zoeyfyi/SmartHomeAdapters/robot/README.md

# Smart Home Adapters - Robot

## Setup 

1. Copy wifi.h into the esp8266 directory `cp wifi.h esp8266/`
2. Enter your SSID and password into wifi.h

## Compile & Run

Use the Arduino IDE
