zoeyfyi/SmartHomeAdapters/reports/technical-report/images/NodeMCU.png

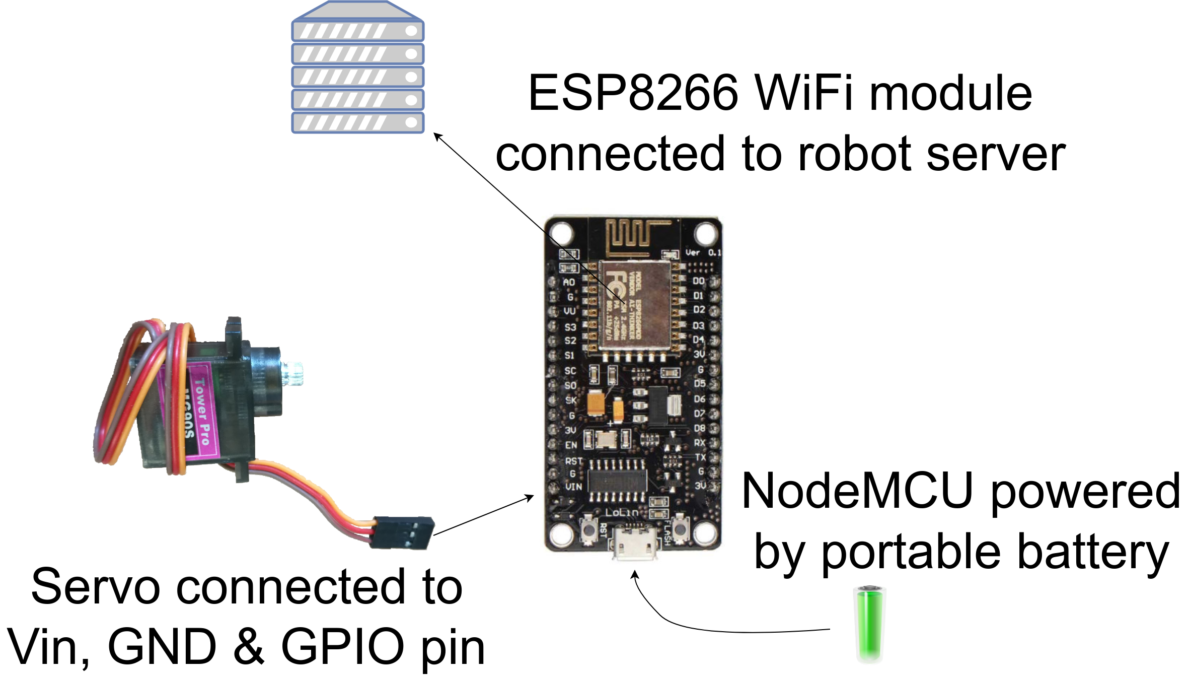
reports/technical-report/images/NodeMCU.png
