zoeyfyi/SmartHomeAdapters/robot/uno-r3/uno-r3.ino

#include <Servo.h>

#define SERVO_PIN 9

Servo servo;

// the setup function runs once when you press reset or power the board
void setup() {
  // begin serial communications
  Serial.begin(9600);
  delay(10);
  
  // initialize digital pin LED_BUILTIN as an output.
  pinMode(LED_BUILTIN, OUTPUT);
  digitalWrite(LED_BUILTIN, LOW);

  // initialize servo
  servo.attach(SERVO_PIN);
}

// the loop function runs over and over again forever
void loop() {
  if(Serial.available() > 0){
      String command = Serial.readString();
      command.trim();

      Serial.print("Received command: ");
      Serial.print(command);
      Serial.println();

      // process LED commands
      if (command.startsWith("led")) {
        if(command == "led on") {
            Serial.println("Turning LED on");
            digitalWrite(LED_BUILTIN, HIGH);
        } else if (command == "led off") {
            Serial.println("Turning LED off");
            digitalWrite(LED_BUILTIN, LOW);
        }
      }

      if (command.startsWith("servo")) {
        // convert characters after "servo " to int
        int angle = command.substring(6).toInt();

        Serial.print("Setting servo to ");
        Serial.print(angle);
        Serial.println(" degrees");

        servo.write(angle);
      }
  }
}
