zoeyfyi/SmartHomeAdapters/(commit log)

2019-01-24 feat: added valid email check and user feedback
    Added checking if the given email matches the
    regex for valid email addresses in AuthenticationActivity
    and RegisterUserActivity.
    Made strings such as button text and input hints
    more intuitive and pleasant as discussed in pull request #31.
    fix: minor typos in the activities.
2019-01-25 docs(project plan): insert gantt chart
2019-01-25 fix(robot): LED not working
    [esp8266.ino]
2019-01-26 feat(robot server): send led on/off message with http request
    /led/on turns the led on
    /led/off turns the led off
2019-01-26 feat(robot): turn led on/off when message is received
2019-01-26 test(robot server): send LED commands
2019-01-26 feat(robot server) return error codes
    Returns 503 when robot is not connected.
    Returns 500 when we can't send a web socket message.
2019-01-26 feat(robot server): detect when socket has been closed
2019-01-27 feat(user server): insert new user into database
2019-01-27 improvement: authentication ui input validation
    Improved the email and password validation input
    by giving concrete feedback to the user when
    their passwords are invalid or do not match,
    checking this upon button click and input
    field focus loss.
    docs: added KDocs documentation comments to
    AuthenticationActivity and RegisterUserActivity.
2019-01-27 refactor: removed unused legacy code
    Removed the interface ButtonUpdater.kt
    and the class NonEmptyTextWatcher.kt as they
    were no longer needed.
2019-01-27 fix(register user): enabled verification btn
    This button was erroneously left disabled by
    default; without the textwatchers it was now
    impossible for the user to enable the button
    and move on with the registration process.
2019-01-28 feat(robot): turn LED on/off over serial
2019-01-28 feat(robot client): connect to arduino and blink LED
2019-01-29 feat(switch server): create basic server
2019-01-29 feat(switch server): dockerise and connect to postgres
2019-01-29 chore(switch server): create switches table
    switches includes the fields:
    - robot ID (ID of the robot)
    - lightOn (true if the switch is on, false otherwise)
2019-01-29 feat(switch server): add register switch robot route
2019-01-29 feat(switch server): return switch object on successful registration
2019-01-29 test(switch server): test register field validation
2019-01-29 test(switch server): succeful registration
2019-01-29 test(switch server): duplicate robot registration error
2019-01-29 feat(switch server): add remove switch route
2019-01-29 test(switch server): update routes
2019-01-29 test(switch server): successfully remove switch
2019-01-29 test(switch server): removing a switch that does not exist
2019-01-29 test(switch server): clear database before each test
2019-01-29 feat(switch server): add routes for turning on and off switches
2019-01-30 feat(android): create blank robot fragment
    Following #46 we will handle fragment transitions and backstack manually.
    [fragment_robot.xml]
2019-01-30 feat(android): pass robot ID from robot list to robot fragment
    [fragment_robot.xml]
2019-01-30 feat(android): display toggle or seek bar depending on robot type
    This is just for testing purposes, once we have a better idea of what features we want I will design a more polished UI.
    [fragment_robot.xml]
2019-01-30 feat(android): add listeners for seek bar and switch controls
2019-01-31 feat(robot): change LED commands to "led on" and "led off"
2019-01-31 feat(robot): parse servo commands over serial
2019-01-31 feat(robot): write angle to servo
2019-01-31 fix(robot): use trim to remove whitespace
    Fixes commands that dont end in a newline not working.
    [uno-r3.ino]
2019-01-31 fix(robot client): pass websocket message directly to arduino
2019-01-31 feat(robot): use built in led for esp8266
2019-01-31 fix(robot): reverse HIGH/LOW on esp8266 built in LED
    [esp8266.ino]
2019-01-31 feat(robot): connect servo to esp8266
2019-01-31 feat(robot server): add endpoint to send servo commands
2019-01-31 test(robot server): servo commands endpoint
2019-02-01 feat(switch server): add calibration infomation to database
2019-02-01 fix(switch server): add switch test bug
2019-02-02 feat: send requests to userserver for auth
    This adds functionality for sending requests to the REST
    API and handling the responses, and uses this functionality
    during registration and login to authenticate via the server.
    Note that login currently doesn't work (or rather always
    returns and subsequently ignores 405) as the server is
    not set up to accept POSTs on /login.
    This also removes the unused layout/code for validating
    the user's email address. This can be re-added later
    if we decide to implement this functionality in the server.
2019-02-02 feat: securely store authorization token locally
    BREAKING CHANGE: The app now requires API >= 23.
    This adds means to store the authorization token
    on the user's device by encrypting it using AES and
    Galois/Counter Mode, storing the keys in Android
    Key Store. Means for retrieving the token are
    also included.
2019-02-03 chore: fix switch server connection to database
    Also add switch server to server docker compose.
2019-02-03 feat(switch server): send robotserver servo commands
2019-02-03 test(switch server): succesfully turning switch on/off
2019-02-03 test(switch server): turn switch on/off failures
2019-02-03 feat(client servo): add info server routes to client server
2019-02-04 feat(switch server): convert to text ID's inline with infoserver
2019-02-04 chore: add switch database volume in server docker-compose
2019-02-04 docs(demo 1): add note on possibly 3D printing switch grip
2019-02-05 feat(switch server): add get status route
2019-02-05 feat(switch server): return all the infomation of the switch
2019-02-05 feat: get robot list and send switch toggle reqs
    The app now dynamically gets the list of robots
    from the server, and is capable of sending
    requests to toggle the switch on or off.
    This also unifies the definition of a Robot
    with the server's definition.
    [fragment_robot.xml]
2019-02-08 refactor(robot server): use grpc for setting led and servos
2019-02-09 fix(switch server): remove switchserver directory from gitignore
2019-02-10 refactor(switch server): convert to grpc
2019-02-10 test(switch server): convert to grpc
2019-02-10 refactor(info server): connect to new grpc switch server
2019-02-12 feat: basic robot registration ui + functionality
    This adds the basic ui for registring robots,
    along with some functionality (QR code scanning,
    etc.).
    [fragment_register_robot.xml]
2019-02-13 build: switch to dockertest and add test tasks
    Dockertest is much more reliable in spawning and purging docker containers during testing.
2019-02-13 improvement: wrap registration in a wizard activity
    [activity_register_robot.xml]
2019-02-16 feat(thermostat server): insert demo thermostat into database
2019-02-16 fix(robot server): start grpc in go thread so http server starts
2019-02-16 feat: robot registration wizard overhaul
    The robot registration steps are now more clearly
    separated, with individual screens for
    1) Scanning/entering the robot ID
    2) Entering the nickname -> Registering robot w/ nickname to user acc
    3) Choosing a use case
    4) Configuration
    Lots of work still remains in these screens, and adding
    functionality for re-doing/deferring 3 & 4 from the main UI at
    a later stage.
    [fragment_configure_robot.xml, fragment_register_robot.xml]
2019-02-17 improvement: show errors to the user in reg wiz
    Errors should now be shown to the user whenever
    they are encountered when making API calls in
    the robot registration wizard.
    [activity_register_robot.xml, fragment_register_robot.xml]
2019-02-17 fix: progress bar visibility
    Fixed a progress bar in RegisterRobotFragment
    being visible soon as the screen is opened
    due to an incorrect xml tag.
    [fragment_register_robot.xml]
2019-02-17 fix: remove rouge xml tag
    [fragment_register_robot.xml]
2019-02-19 feat(switch server): add method for setting calibration parameters
2019-02-19 feat(info server): parse calibration fields and pass to switch server
2019-02-19 feat(client server): add /robot/:id/calibration endpoint
2019-02-22 fix: fragment no longer terminating immediately
    Fixed a bug/error in SelectUseCaseFragment which caused
    it to finish immediately after the use case spinner
    was set up.
2019-02-22 fix: added missing parameter grid
    [fragment_configure_robot.xml]
2019-02-23 chore: added temporary error-ignoring code
    Added code which temporarily ignores the
    server not accepting a robot registration
    call (as it is not currently up on
    the webserver). This should be removed
    in the production version.
2019-02-23 improvement: resolved minor warnings throughout
    Resolved minor warnings throughout the code,
    for example by removing now unused imports and
    extracting button texts into @string resources.
2019-02-23 fix: enabled retries after user fails to set nick
    Fixed a bug preventing the user from trying again
    if they pressed the button to register the robot
    without having entered a nickname.
2019-02-23 fix: use case registration call: POST -> PUT
    Changed the HTTP request method used when registering
    a use case to a robot from POST to PUT, to align with
    PR #99.
2019-02-23 feat: read config input and send to server
    Added functionality for reading the values
    of the configuration parameters and sending
    them to the web server.
    [fragment_configure_robot.xml]
2019-02-23 fix: removed button for delaying configuration
    Removed a button which implied that the user
    could delay configuration of the robot until
    later. This is behaviour we want to support
    but which is not appropriately handed right now,
    and so the user should not be given the choice.
2019-02-23 feat: show current value of seek bar
    [fragment_robot.xml]
2019-02-24 improvement: merged nickname frag into qr frag
    Merged RobotRegistrationFragment, where the user enters
    the new robot's nickname, with QRFragment where the user
    scans/enters the ID for the robot. Not quite sure why
    these were separated in the first place...
    [fragment_register_robot.xml]
2019-02-25 fix(switch server): send ID on servo request
2019-02-25 feat(info server): add get calibration method
2019-02-25 feat(client server): GET /robot/:id/calibration route
2019-02-25 fix(robot server): lock sockets in sendMessage
2019-02-26 fix(client server): swap min/max for off angle switch calibration
2019-02-26 fix(client server): add types to thermostat calibration parameters
2019-02-27 docs: soldering -> esp dev
2019-03-15 chore: removed legacy code and tests
    Removed legacy code such as the RegisterUserActivity
    and tests testing this legacy code, including all
    current instrumented tests.
2019-03-17 build: switch to golangci-lint for linting
2019-03-17 stlye(switchserver): fix linting errors
2019-03-17 refactor: renamed authorization button
2019-03-20 feat(switchserver): remove dockertest use microservice package
2019-03-20 fix(switchserver): build errors
2019-03-20 fix(switchserver): not clearing database before each test
2019-03-26 feat: use case selection w/ new UI
2019-03-26 fix: added missing case for range/thermostat
2019-03-28 feat: skeleton of robot edit mode
    [fragment_edit_robot.xml]
2019-03-28 fix(switchserver): lint errors
2019-03-30 improvement: extracted use case adapter
2019-03-30 improvement: use string resources throughout
    [fragment_edit_robot.xml]
2019-03-31 feat(switchdb): remove default value
2019-03-31 feat: robot deletion
    [fragment_edit_robot.xml]
2019-03-31 fix: progress bar hidden until API call made
    [fragment_edit_robot.xml]
2019-03-31 refactor(usecaseserver): complete rewrite
    The wrapper is not a much higher level of abstraction. Now all you have to define is what parameters you need and how the servo should behave when a toggle/range request is made.
2019-03-31 feat(usecaseserver): add switch usecase
2019-04-01 refactor(switchserver): remove
2019-04-01 build: replace switch/thermostat with usecase
2019-04-01 refactor(switchdb): remove
2019-04-01 build: remove switch/thermostat server commands
2019-04-01 ci(circleci): remove testing switch/thermostat
2019-04-01 fix(infoserver): reference to switchserver
2019-04-01 feat(boltlockserver): add to usecaseserver
2019-04-01 refactor(boltlockserver): change angles to lock/unlock
2019-04-01 feat: state-dependant UI for switches
2019-04-01 improvement: nicer use case selection UI
2019-04-01 fix: titles no longer overflow width of screen
    [fragment_edit_robot.xml]
2019-04-02 refactor(infoserver): calibration parameters
2019-04-02 refactor(clientserver): calibration routes
2019-04-02 feat: new calibration UI
    [fragment_configure_robot.xml]
2019-04-02 refactor(usecaseserver): change Boltlock to boltlock
2019-04-02 feat: 'boltlock' use case now supported
2019-04-02 improvement: capitalize use case names in list
2019-04-02 feat: interact with robots in config screen
    [fragment_configure_robot.xml]
2019-04-03 docs: I'm tired
    Hi tired, I'm Dad.
2019-04-03 feat(infoserver): add button press method
2019-04-03 feat(infoserver): implement button press method
2019-04-03 feat(robotserver): send button press to infoserver
2019-04-08 chore: deleted unused fragment
    [fragment_robot.xml]
